jackjburnett/JBMK-Controller/README.md

# JBMK-Controller
Controller Files from ASSIST HEIDI Summer School 2025
