jackjburnett/JBMK-Controller/Controller.3mf

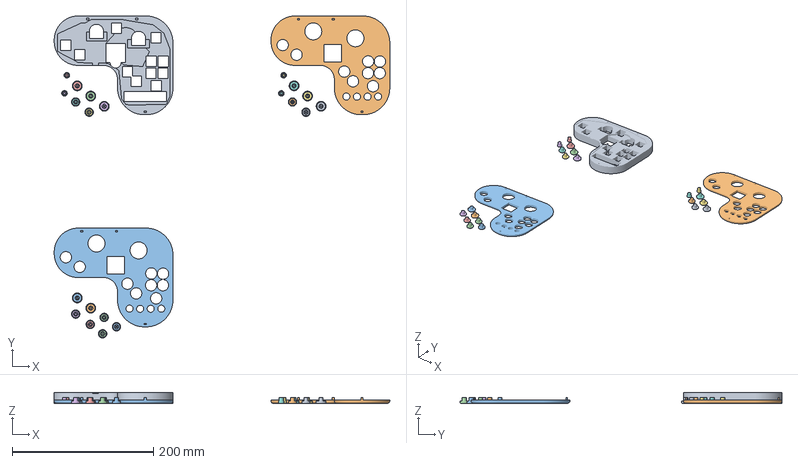
[picture p2: CAD file, 2026-10-14]
Controller.3mf
475.5 x 456.2 x 15.0 mm
Housing.STEP
Top.STEP x 2
14mm_button.step x 8
12mm_button.step x 9
8mm_button.step x 4
