jackjburnett/JBMK-Controller/STEP Files/12mm_button.step

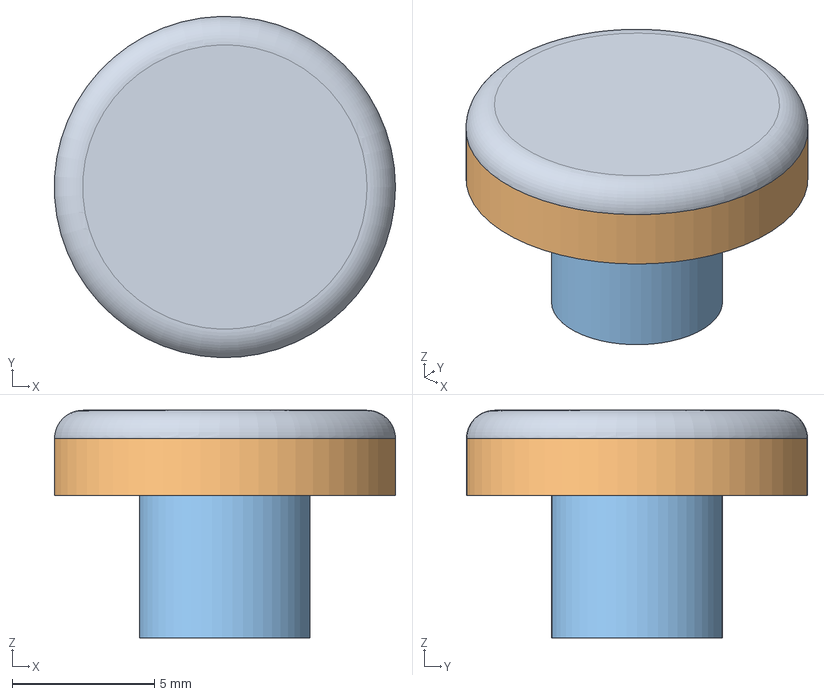
[picture p3: CAD file, 2026-10-14]
STEP Files/12mm_button.step
12.0 x 12.0 x 8.00 mm
f6bfc80a-c7bf-11f1-9fb2-300505fafcf2
f6d14d88-c7bf-11f1-91cb-300505fafcf2
f6e1d804-c7bf-11f1-9755-300505fafcf2
