jackjburnett/JBMK-Controller/STEP Files/14mm_button.step

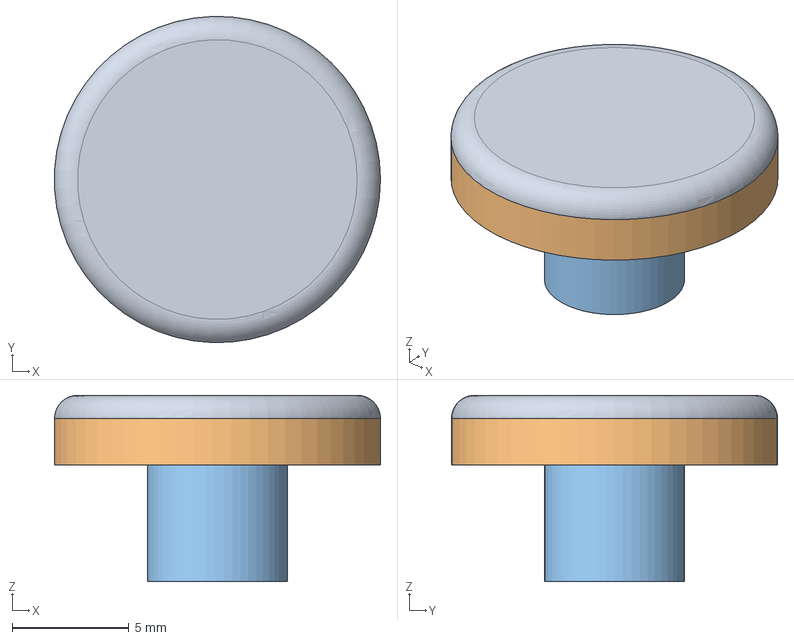
[picture p4: CAD file, 2026-10-14]
STEP Files/14mm_button.step
14.0 x 14.0 x 8.00 mm
db2bc314-c7bf-11f1-8538-300505fafcf2
db404e15-c7bf-11f1-bf89-300505fafcf2
db60b4a0-c7bf-11f1-94af-300505fafcf2
