jackjburnett/JBMK-Controller/STEP Files/8mm_button.step

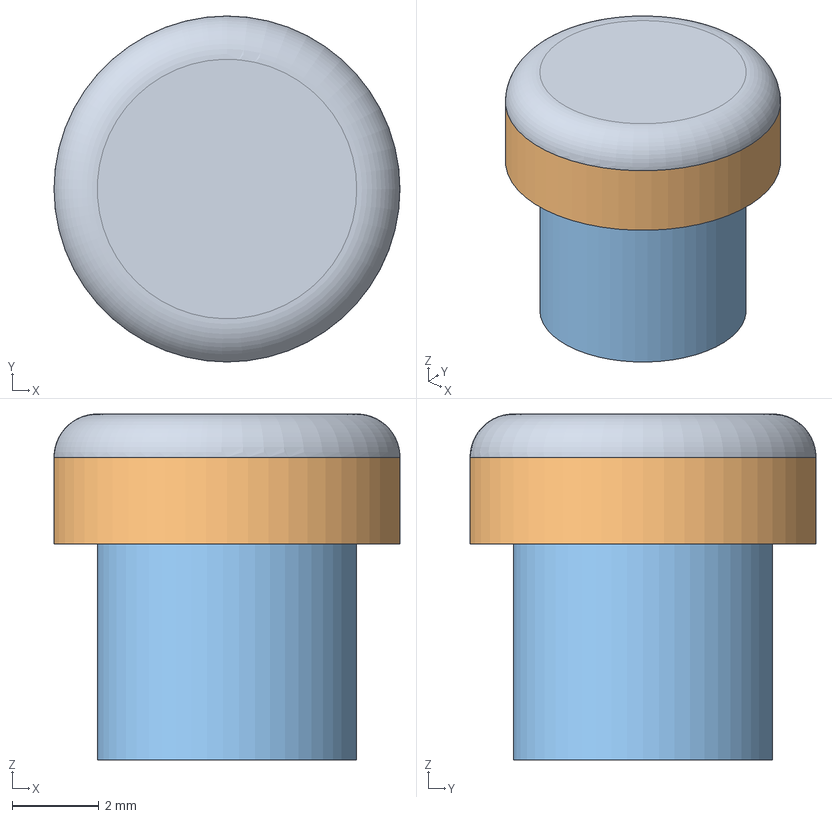
[picture p5: CAD file, 2026-10-14]
STEP Files/8mm_button.step
8.00 x 8.00 x 8.00 mm
be6f6855-c7bf-11f1-a2cb-300505fafcf2
be88b78e-c7bf-11f1-a45b-300505fafcf2
bea20ae0-c7bf-11f1-b7a6-300505fafcf2
