jackjburnett/JBMK-Controller/STEP Files/Base.STEP

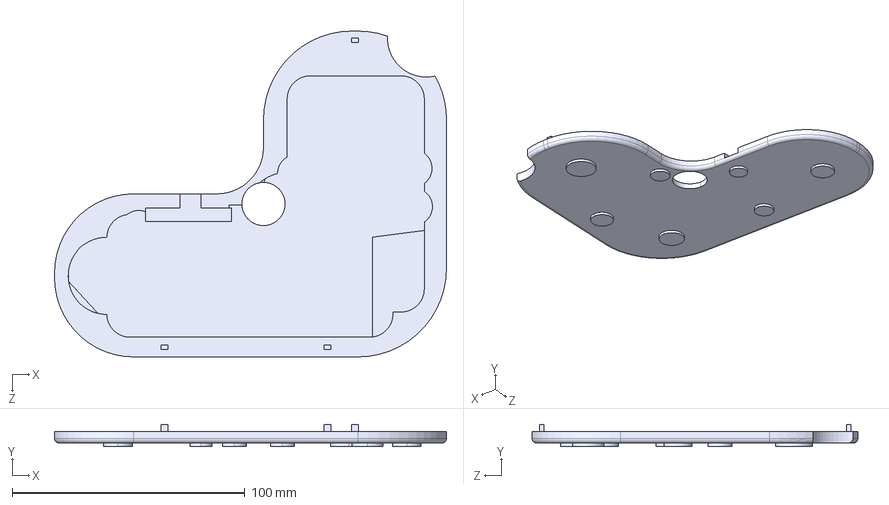
[picture p6: CAD file, 2025-10-22]
STEP Files/Base.STEP
168.3 x 9.50 x 139.9 mm
