jackjburnett/JBMK-Controller/STEP Files/Top.STEP

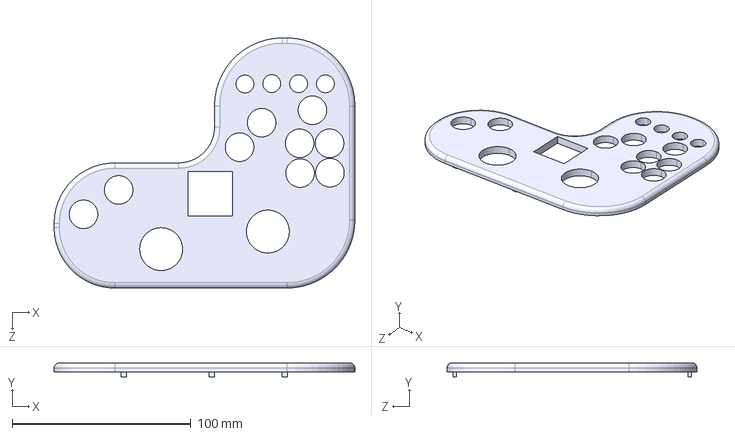
[picture p7: CAD file, 2025-10-22]
STEP Files/Top.STEP
168.3 x 8.00 x 139.9 mm
