jackjburnett/JBMK-Controller/STEP Files/Housing.STEP

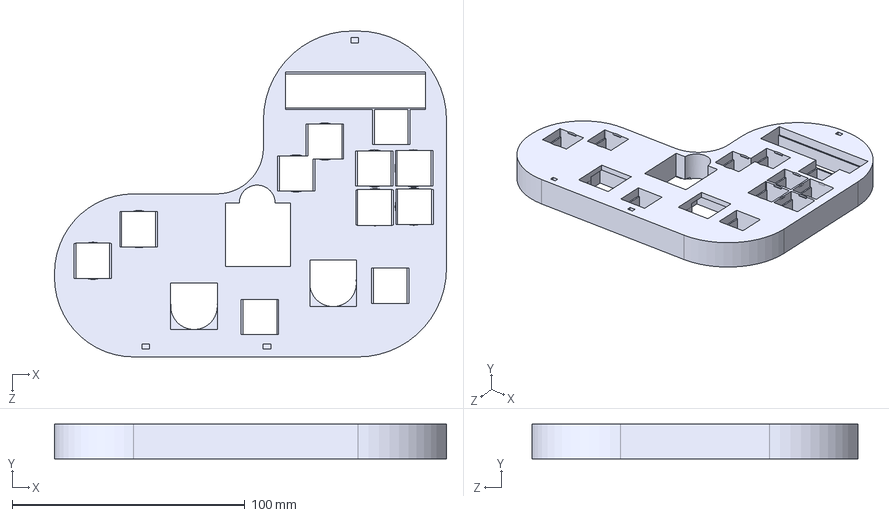
[picture p8: CAD file, 2025-10-22]
STEP Files/Housing.STEP
168.3 x 15.0 x 139.9 mm
