jackjburnett/JBMK-Controller/(commit log)

2025-10-22 Added initial files
    [Base.STEP, Housing.STEP, Top.STEP]
2026-10-14 Button STEP Files
    [12mm_button.step, 14mm_button.step, 8mm_button.step]
2026-10-14 OrcaSlicer Files
    [Controller.3mf]
